WSU-RoboticsClub/BeerPong_TeamB/README.md

# BeerPong Team B

This repository contains the microcontroller and PC code for Team B's beer-pong playing robot.
