WSU-RoboticsClub/BeerPong_TeamB/Microcontroller/AVR/board/AVR_Beerpong_Board.kicad_pcb

## KiCad design Microcontroller/AVR/board/AVR_Beerpong_Board.kicad_pcb (2016-01-07)

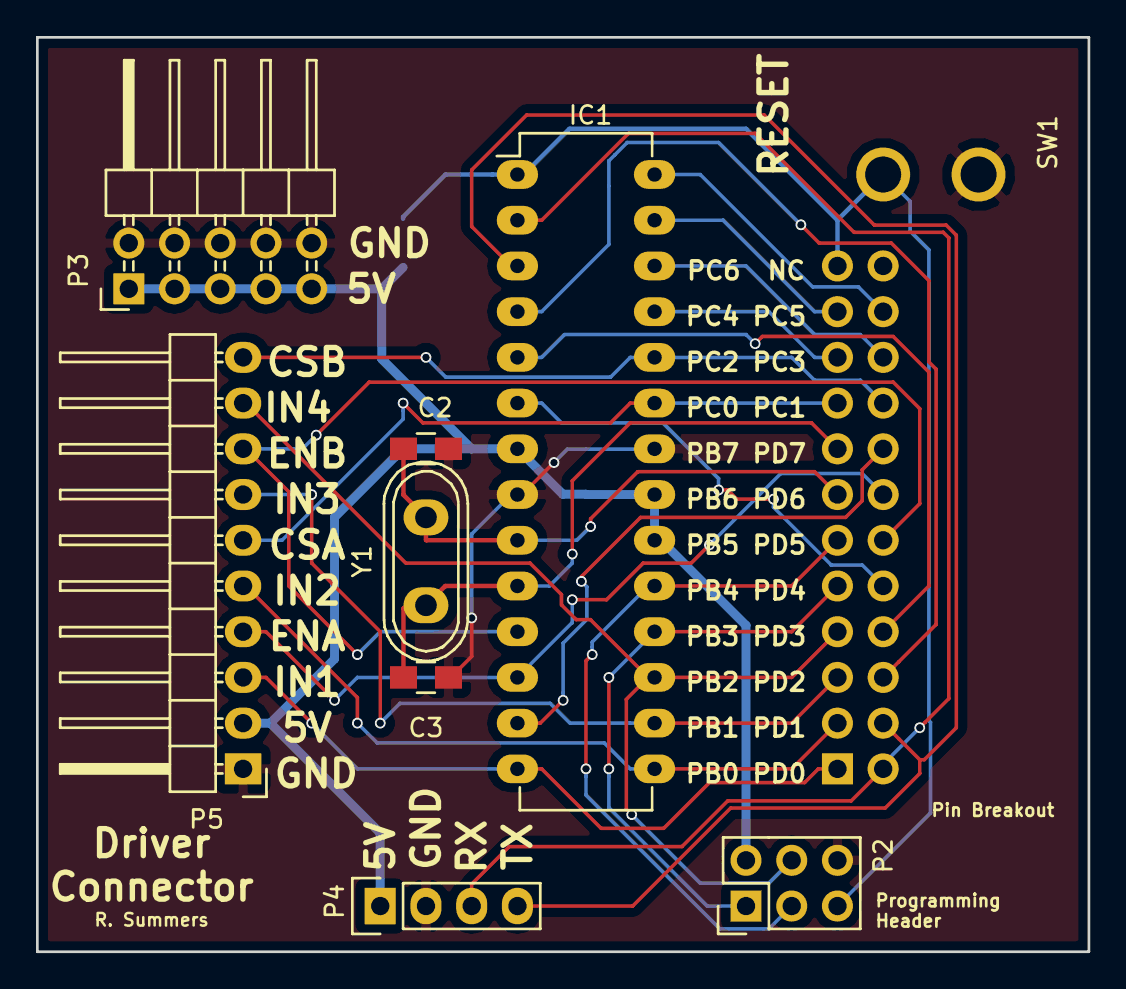
[picture p1: board AVR_Beerpong_Board.kicad_pcb from above]

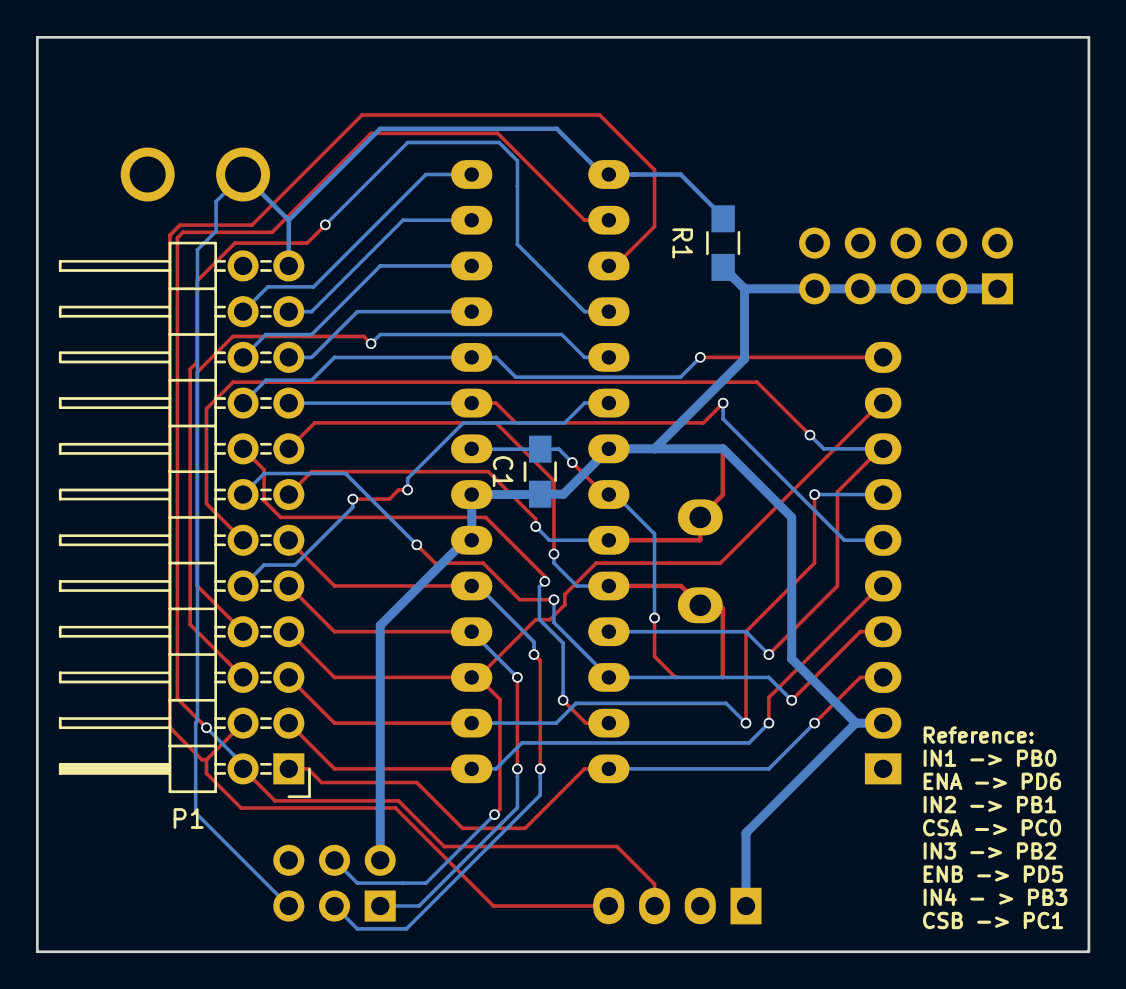
[picture p2: board AVR_Beerpong_Board.kicad_pcb from below]

Board: 2 copper layers, 58.4 x 50.8 mm, 12 parts (3 on the bottom side), 25 nets.

Parts:
C1: .1uF; C_0805_HandSoldering
C2, C3: 18pF; C_0805_HandSoldering
IC1: ATMEGA328P-P; DIP-28_W7.62mm_LongPads
P1: PIN_BREAKOUT; Pin_Header_Angled_2x12
P2: CONN_02X03; Pin_Header_Straight_2x03
P3: PWR; Pin_Header_Angled_2x05
P4: UART+PWR; Pin_Header_Straight_1x04
P5: Driver_Conn; Pin_Header_Angled_1x10
R1: 10k; R_0805_HandSoldering
SW1: SW_PUSH; Switch
Y1: 16MHz; Crystal_HC50-U_Vertical

Connections:
+5V: C1.1, IC1.7, IC1.20, IC1.21, P2.2, P3.1, P3.3, P3.5, P3.7, P3.9, P4.1, P5.2, R1.1
/CSA: IC1.23, P1.17, P5.6
/CSB: IC1.24, P1.18, P5.10
/ENA: IC1.12, P1.14, P5.4
/ENB: IC1.11, P1.12, P5.8
/PB0: IC1.14, P1.1, P5.3
/PB1: IC1.15, P1.3, P5.5
/PB2: IC1.16, P1.5, P5.7
/PB3: IC1.17, P1.7, P2.4, P5.9
/PB4: IC1.18, P1.9, P2.1
/PB5: IC1.19, P1.11, P2.3
/PB6: C2.2, IC1.9, P1.13, Y1.1
/PB7: C3.2, IC1.10, P1.15, Y1.2
/PC2: IC1.25, P1.19
/PC3: IC1.26, P1.20
/PC4: IC1.27, P1.21
/PC5: IC1.28, P1.22
/PC6: IC1.1, P1.23, P2.5, R1.2, SW1.1
/PD0: IC1.2, P1.2, P4.3
/PD1: IC1.3, P1.4, P4.4
/PD2: IC1.4, P1.6
/PD3: IC1.5, P1.8
/PD4: IC1.6, P1.10
/PD7: IC1.13, P1.16
GND: C1.2, C2.1, C3.1, IC1.8, IC1.22, P2.6, P3.2, P3.4, P3.6, P3.8, P3.10, P4.2, P5.1, SW1.2
