WSU-RoboticsClub/BeerPong_TeamB/Microcontroller/PIC/board/PIC_Beerpong_Board.kicad_pcb

## KiCad design Microcontroller/PIC/board/PIC_Beerpong_Board.kicad_pcb (2016-02-07)

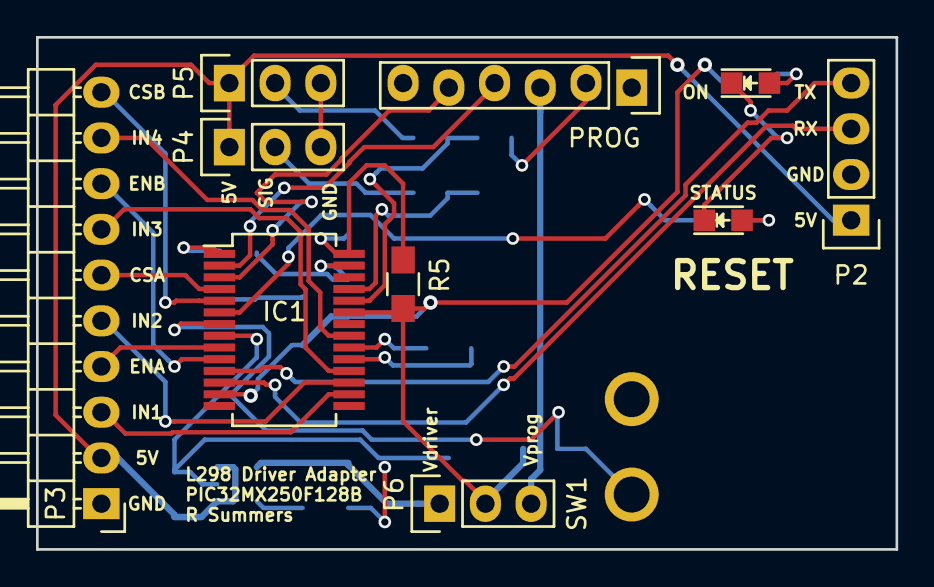
[picture p3: board PIC_Beerpong_Board.kicad_pcb from above]

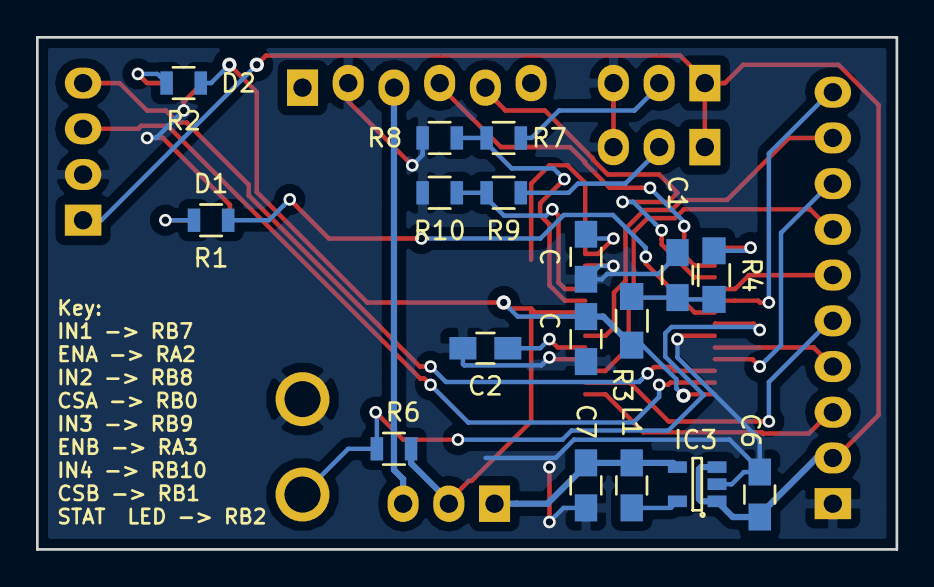
[picture p4: board PIC_Beerpong_Board.kicad_pcb from below]

Board: 2 copper layers, 47.8 x 28.4 mm, 28 parts (17 on the bottom side), 30 nets.

Parts:
C, C1, C2: C; C_0805_HandSoldering
C6: 4.7uF; C_0805_HandSoldering
C7: 10uF; C_0805_HandSoldering
C#2: C; C_0805_HandSoldering
D1, D2: LED; LED_0805
IC1: PIC32MX2xx/1xx; SSOP-28_5.3x10.2mm_Pitch0.65mm
IC3: LM3671; SOT-23-5
L1: 2.2uH; C_0805_HandSoldering
P2: CONN_01X04; Pin_Header_Straight_1x04
P3: CONN_01X10; Pin_Header_Angled_1x10
P4, P5, P6: CONN_01X03; Pin_Header_Straight_1x03
PROG: CONN_01X06; Pin_Header_Staggered_1x06
R1, R2, R6, R7, R8, R9, R10: R; R_0805
R3: 10k; R_0805_HandSoldering
R4: 470; R_0805_HandSoldering
R5: R; R_0805_HandSoldering
SW1: SW_PUSH; Switch

Connections:
+3V3: C.1, IC1.13, IC1.23, P6.2, R2.1, R3.1, R5.2, R6.1
+5V: C6.1, IC3.1, IC3.3, P2.1, P3.2, P4.1, P5.1
/3V3_PROG: P6.3, PROG.3
/HE1: P4.2, R9.1
/HE2: P5.2, R7.1
/Sheet56A51C6D/AVDD: C#2.1, IC1.28, R5.1
/Sheet56A51C6D/MRX: IC1.12, P2.3
/Sheet56A51C6D/MTX: IC1.11, P2.4
/Sheet56A51C6D/RA0: IC1.2, PROG.4
/Sheet56A51C6D/RA1: IC1.3, PROG.5
/Sheet56A51C6D/RA2: IC1.9, P3.4
/Sheet56A51C6D/RA3: IC1.10, P3.8
/Sheet56A51C6D/RB0: IC1.4, P3.6
/Sheet56A51C6D/RB1: IC1.5, P3.10
/Sheet56A51C6D/RB2: IC1.6, R1.1
/Sheet56A51C6D/RB3: IC1.7, R6.2, SW1.1
/Sheet56A51C6D/RB7: IC1.16, P3.3
/Sheet56A51C6D/RB8: IC1.17, P3.5
/Sheet56A51C6D/RB9: IC1.18, P3.7
/Sheet56A51C6D/RB10: IC1.21, P3.9
/Sheet56A51C6D/RB13: IC1.24, R7.2, R8.1
/Sheet56A51C6D/RB14: IC1.25, R9.2, R10.1
/Sheet56A51C6D/~MCLR: IC1.1, R4.1
/Sheet56A51CCD/Vout: C7.1, IC3.4, L1.2, P6.1
GND: C.2, C1.2, C2.2, C6.2, C7.2, C#2.2, D1.1, D2.1, IC1.8, IC1.19, IC1.27, IC3.2, P2.2, P3.1, P4.3, P5.3, PROG.2, R8.2, R10.2, SW1.2
unnamed: C1.1, R3.2, R4.2
unnamed: C2.1, IC1.20
unnamed: D1.2, R1.2
unnamed: D2.2, R2.2
unnamed: IC3.5, L1.1
