WSU-RoboticsClub/BeerPong_TeamB/Microcontroller/AVR/include/BeerPong.h

/*
 * BeerPong.h
 *
 * Created: 12/20/2015 8:42:58 PM
 *  Author: Ryan
 */ 


#ifndef BEERPONG_H_
#define BEERPONG_H_


#ifdef	__cplusplus
extern "C" {
#endif


/* Includes */
#include "sublibinal.h"
#include <string.h>
/* Global Definitions */
#define BUFFER_SIZE 256 // This defines the size of the UART buffers !!DO NTO CHANGE THIS FFS!!

//Serial Description Bytes
#define M1_STATUS_DUTYCYCLE 0x01
#define M2_STATUS_DUTYCYCLE 0x02
#define M1_STATUS_CURRENT 0x03
#define M2_STATUS_CURRENT 0x04
#define M1_SET_DUTYCYCLE 0x05
#define M2_SET_DUTYCYCLE 0x06
#define M1_READ_RPM 0x07
#define M2_READ_RPM 0x08
#define M1_STATUS_RPM 0x09
#define M2_STATUS_RPM 0x0A

#define PB_CLK 16000000


/* Function Prototypes */

//Motors
void configureMotors(); //Configuration and instantiation of the flywheel motors
void motor_callback(); //Callback for Timer_0 overflow	

void configureFeedback();
void interrupt_m1(); //Callback function for feedback for motor 1
void interrupt_m2(); //Callback function for feedback for motor 2
void feedback_tmr_ovf();



//Serial
void establishUART(); //Create our serial interface with packetizer enabled
void packetizer_callback(uint8 *message, uint8 size); //Callback for the packetizer receive

//ADC
void configureADC();
void processADC(ADC_Node node);


//Feedback
void configureFeedback_Timer();
void feedback();

#ifdef	__cplusplus
}
#endif



#endif /* BEERPONG_H_ */
