WSU-RoboticsClub/BeerPong_TeamB/(commit log)

2015-12-03 Added Flow for the Motors
2015-12-04 Motors will now run based on timer 1.
2015-12-04 Changed PWM frequency
2015-12-20 Refactor of the Microcontroller Code
    The new code changes establish an interface for a command module on a laptop
    to interface with the microcontroller to set and read RPMs of the motors
    so that a feedback system can be put in place.
    Future commits will add in computer-side GUI to read status of the Robot
2015-12-20 Addition of GUI and Microcontroller Rework
    This commit adds in a GUI to control the microcontroller motor goals
    It also establishes efficient communication methods between the microcontroller and the computer.
    [main.c, motors.c]
2015-12-21 Addition of makefile for linux compilation
    This commit adds in a makefile for linux compilation and upload.
    Once the makefile has been run, upload the hex file created onto the
    AVR microcontroller board.
2015-12-21 Addition of Feedback System
    This commit adds in feedback for motor 1 so that true RPMs can be known.
2015-12-21 Addition of PID controller
    This commit adds in a PID controller so that the motor can control its speed.
2016-01-06 Addition of Motor 2 controls
    Still buggy, figuring out sync issues.
    [BeerPong.h, main.c, motors.c, serial.c]
2016-01-06 Cleanup of Repo and adjustment to GUI
    The GUI was corrected to ensure that commands were sent and received, and that sync would be fixed
    There are still issues with acquiring sync and keeping a stable line of communication. This should be reworked in the future.
    Also, it appears that the driver may be overcurrenting.
    [BeerPong.h, motors.c, serial.c]
2016-01-07 Addition of Board project files
    This commit adds in the breakout board project files for KiCAD
    [AVR_Beerpong_Board.kicad_pcb, AVR_Beerpong_Board.sch]
2016-01-18 Restructure of the GUI to utilize threading
    This also makes the code a LOT more stable. The PID controller calculations
    within an ISR were causing the microcontroller to periodicially crash, as the ISRs
    were taking too long to complete and were backing up. Instead, a flag is now set
    so that the background processing can occur without blocking interrupts.
    [BeerPong.h, main.c, motors.c, serial.c]
2016-01-23 Addition of PID Control on computer side
    This commit changes the PID control to rely on the computer.
2016-01-23 Addition of PID Controller FPS
    Forgot to add in a timer for the controller.
2016-02-07 Refactor of the microcontroller code base
    [AVR_Beerpong_Board.kicad_pcb, AVR_Beerpong_Board.sch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]
